Sivigik/SI_2015/dossier/emetteur.tex

\scalebox{0.5} % Change this value to rescale the drawing.
{
\begin{pspicture}(0,-7.03)(24.62,7.03)
\rput(12.31,0.0){}
\end{pspicture} 
}
