Sivigik/SI_2015/Partie vidéo robot SI.odt

Émetteur UHF vidéo

Le robot a pour principal objectif de découvrir des zones inaccessibles ou dangereuses à l'homme, ou un lieu trop exigu pour s'y déplacer.

La mise en place d'une retransmission vidéo est donc primordiale pour son contrôle par l'utilisateur.

Nous avons donc mis une caméra générant un signal vidéo composite, ce signal est envoyé par un émetteur UHF à distance pour être reçu par un écran positionné sur la manette de contrôle.

Signal vidéo composite

La caméra que nous utilisons ne gère pas la couleur, donc nous ne nous intéresserons pas à la porteuse couleur du signal.

Il existe plusieurs systèmes d'encodage, celui qui est ici employé est le PAL, ses caractéristiques sont qu'il transmet 25 images à la seconde pour une résolution max de 720 × 576 pixels.

Le signal véhicule les informations sous forme analogique et numérique,

la luminance (noir et blanc) par analogique, ce qui donne pour chaque ligne une période du signal, la tension du signal affichée dans le cadre rouge définit la luminance d'une ligne entière de l'écran, sa tension est définie entre 0,3V et 1V ; à 0,3V on a du noir, puis à 1V du blanc. Le signal présent dans les cadres bleus définit le début et la fin de ligne.

Synchronisation de ligne

Luminance pour une ligne

Luminance pour une ligne

Synchronisation de ligne

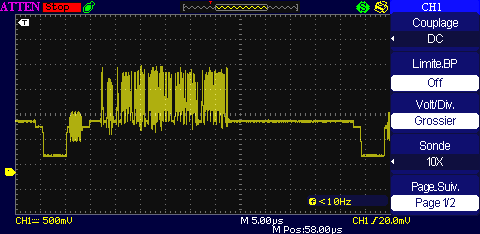
[picture p1: figure]

Vu d'un ensemble de ligne :

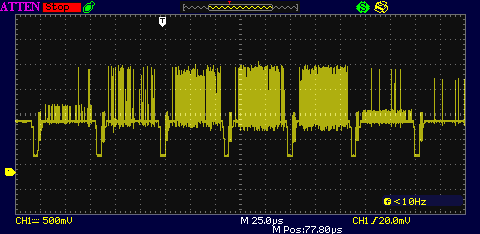
[picture p2: figure]

Il y a ensuite la synchronisation de frame qui est véhiculée par un signal numérique (il y passe aussi par cet endroit des informations sur la sources du signal, ici aucun car c'est une simple caméra).

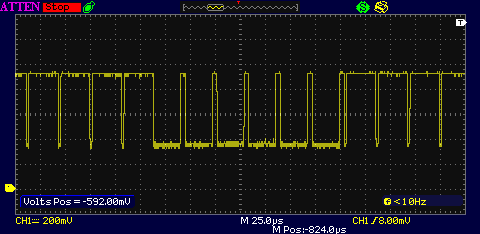
[picture p3: figure]

Se qui donne une image sous cette forme :

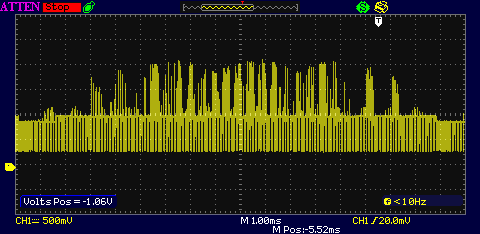
[picture p4: figure]

Émetteur UHF

Schéma :

L'émetteur est basé sur un oscillateur Colpitts, ce qui nous permet d'obtenir une fréquence élevée et stable avec seulement un transistor et quelques composants.

La fréquence de ce type d’oscillateur est donné par f= 1 over {2 %pi sqrt{L_1 times {{C_7 times C_2} over { C_7 + C_2}}}}

J'ai donc régler la fréquence de l'émetteur pour être entre la chaîne 58 et 60, soit entre 759,25 MHz

et 783,25 MHz, qui donne C_7 = 2pf C_2 = 10pF et L_1 = 20nH

donc f = 1 over { 2 %pi sqrt{{ 2.10^-8 {2 . 10^-12 times 1 . 10^-11} over {2 . 10^-12 + 1 . 10^-11}}}} = 8.71728.10^8 Hz soit 871,728MHz .

La transmission de données se fait par modulation de la fréquence, donc pour faire passer les informations vidéo il suffit de faire varier la tension aux bornes du condensateur C_2 , ce qui se répercute sur la fréquence d’oscillation. L'amplitude de modulation de la fréquence doit pouvoir être réglable pour avoir une transmission optimale.

Donc le signal vidéo composite passe par un potentiomètre, nous permettant ainsi de modifier son amplitude, puis le pont de résistance ne fait que protéger la caméra en cas de retour de tension de l'oscillateur.

L’antenne est directement mise sur la sortie de l'oscillateur, sa longueur dépend de la longueur d'onde, qui se calcule par la relation %lambda = c over f .

c vaut la vitesse de l'électricité soit 299 792 458 m.s^-1 et f = 871,728 . 10^6

%lambda = {299 792 458} over {871,728 . 10^6} = 0,3439 m

Aux vues de la puissance de transmission et du peu de place libre , j'ai opté de prendre un multiple de la longueur d'onde, soit, en divisant par 6, donc une longueur de 0,0573 m soit 57,3 mm .

Récepteur vidéo

La réception se fait par un TUNER d'un ancien téléviseur portable, sur lequel la sélection de la fréquence des chaînes se fait par la variation de tension sur une entrée du TUNER, puis il y a une sortie composite directement reliée à une entrée du circuit intégré CSC5151 qui contrôle le tube cathodique. Le signal composite est récupéré pour être affiché sur un écran LCD fixé sur la manette.
