Sivigik/SI_2015/diapo/IMG_1891.jpg

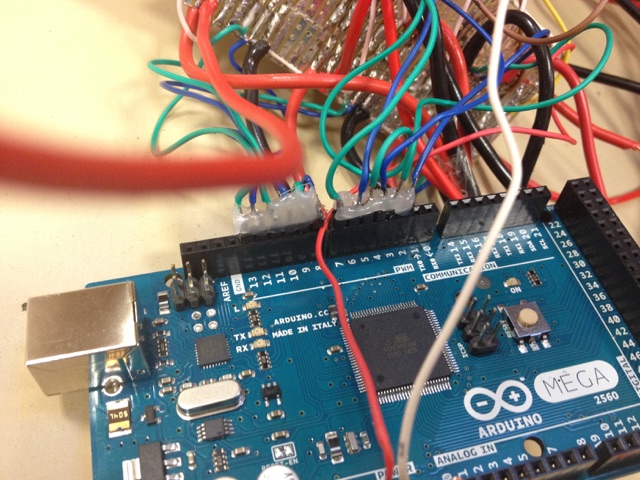
diapo/IMG_1891.jpg
