Sivigik/SI_2015/diapo/IMG_4512.jpg

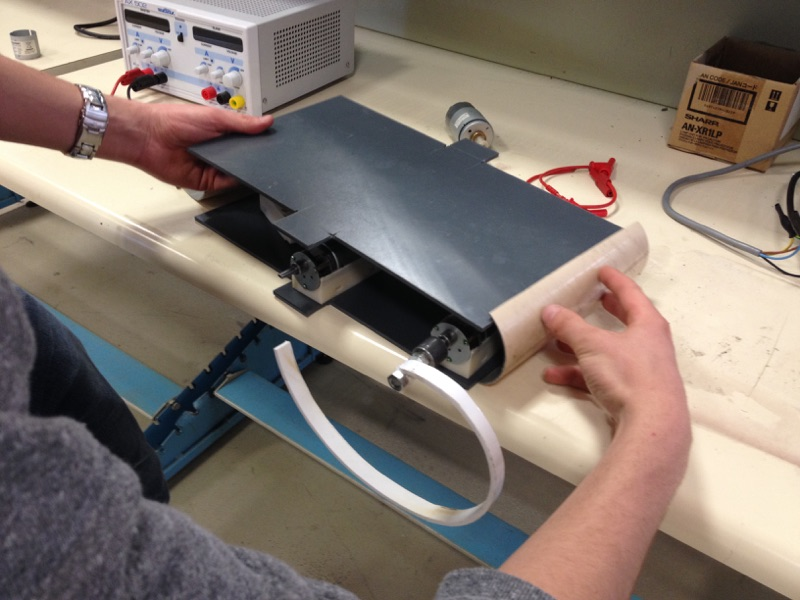
diapo/IMG_4512.jpg
