Sivigik/SI_2015/diapo/IMG_4847.jpg

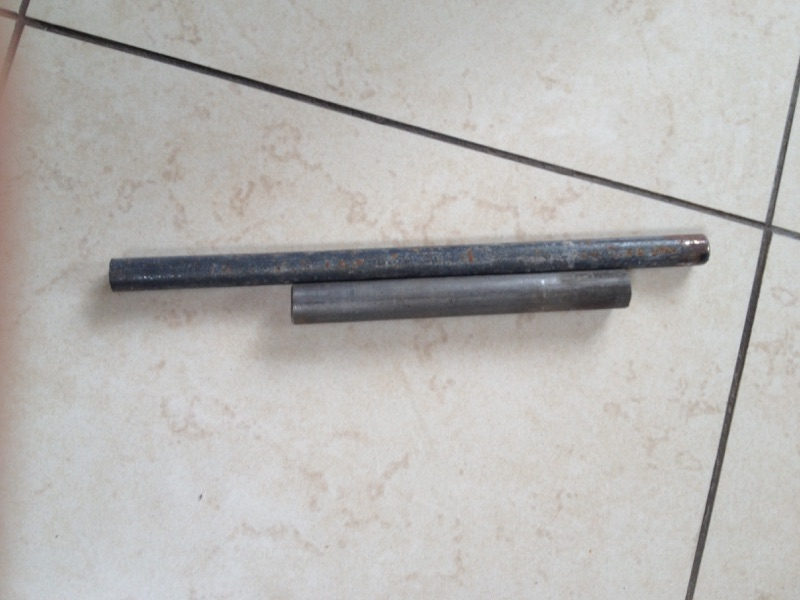
diapo/IMG_4847.jpg
