Sivigik/SI_2015/diapo/IMG_5082.jpg

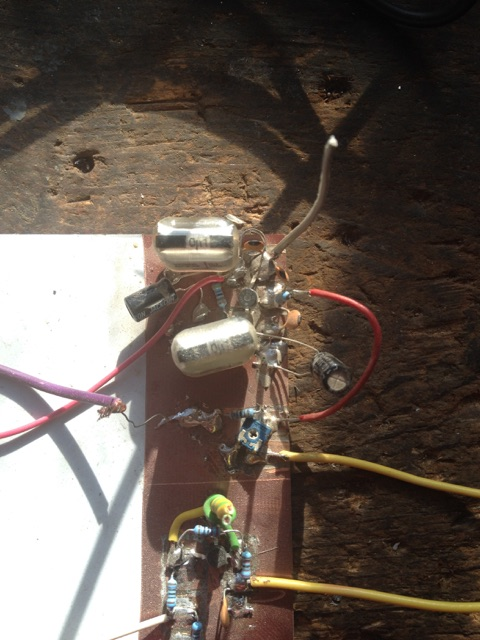
diapo/IMG_5082.jpg
