Sivigik/SI_2015/diapo/IMG_20150120_155957.jpg

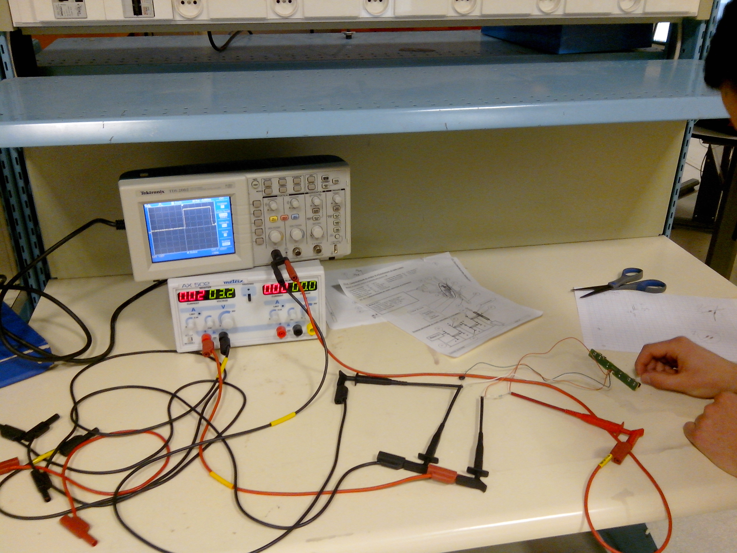
diapo/IMG_20150120_155957.jpg
