Sivigik/SI_2015/diapo/IMG_20150120_160013.jpg

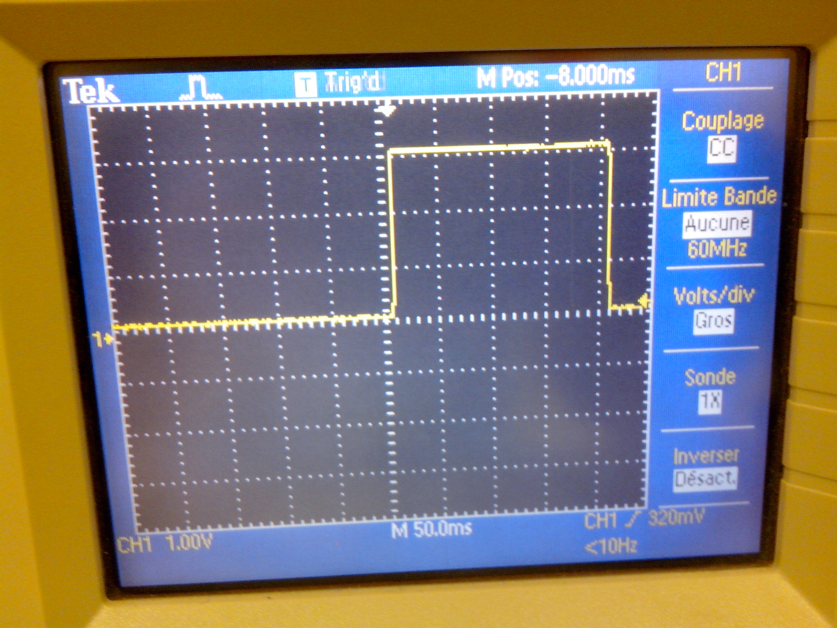
diapo/IMG_20150120_160013.jpg
