Sivigik/SI_2015/diapo/IMG_20150404_164022.jpg

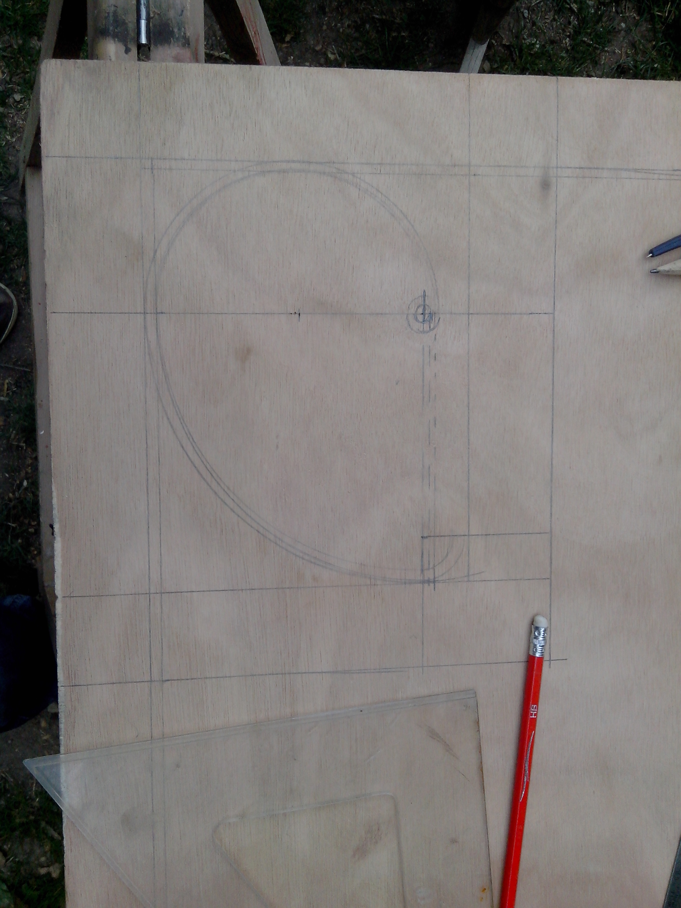
diapo/IMG_20150404_164022.jpg
