Sivigik/SI_2015/diapo/IMG_20150404_175506.jpg

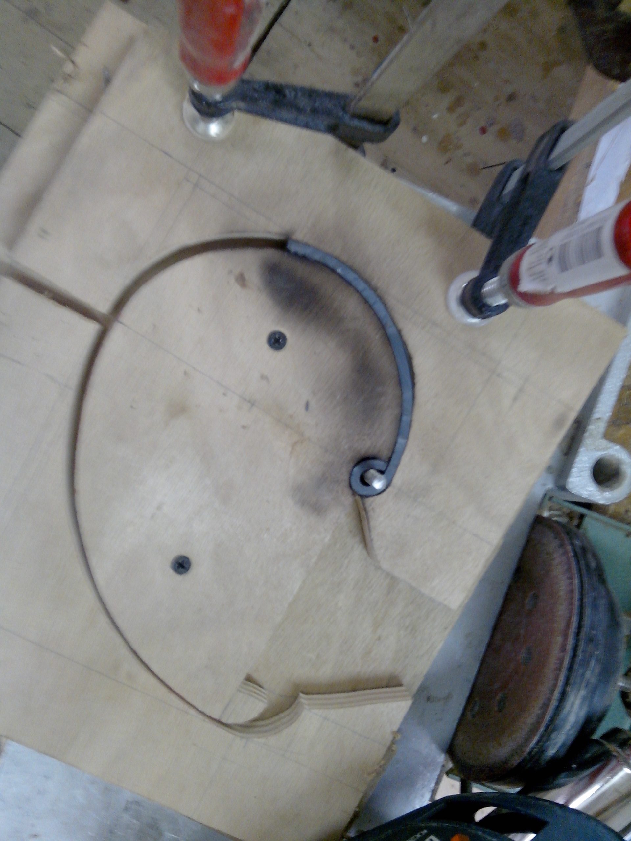
diapo/IMG_20150404_175506.jpg
