Sivigik/SI_2015/diapo/IMG_20150414_223907.jpg

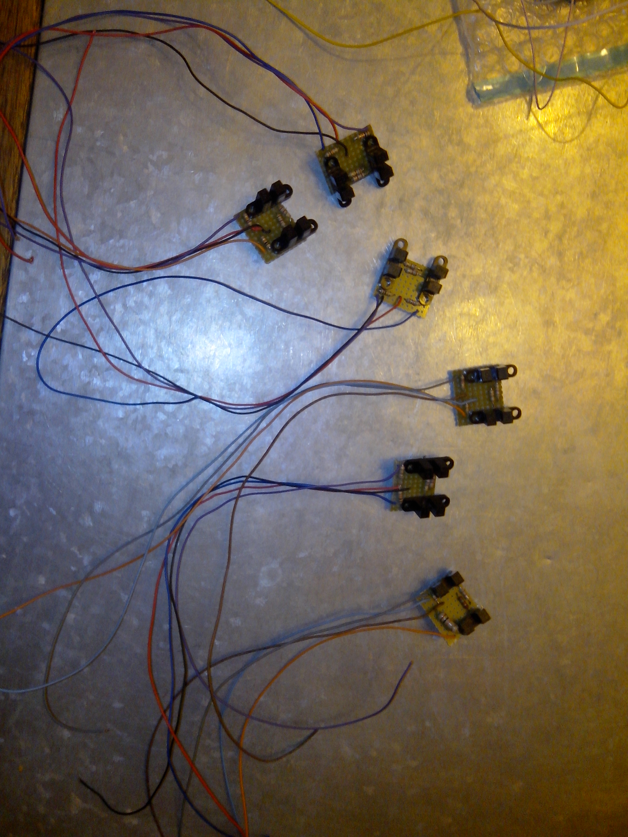
diapo/IMG_20150414_223907.jpg
