Sivigik/SI_2015/dossier/images/emetteur.png

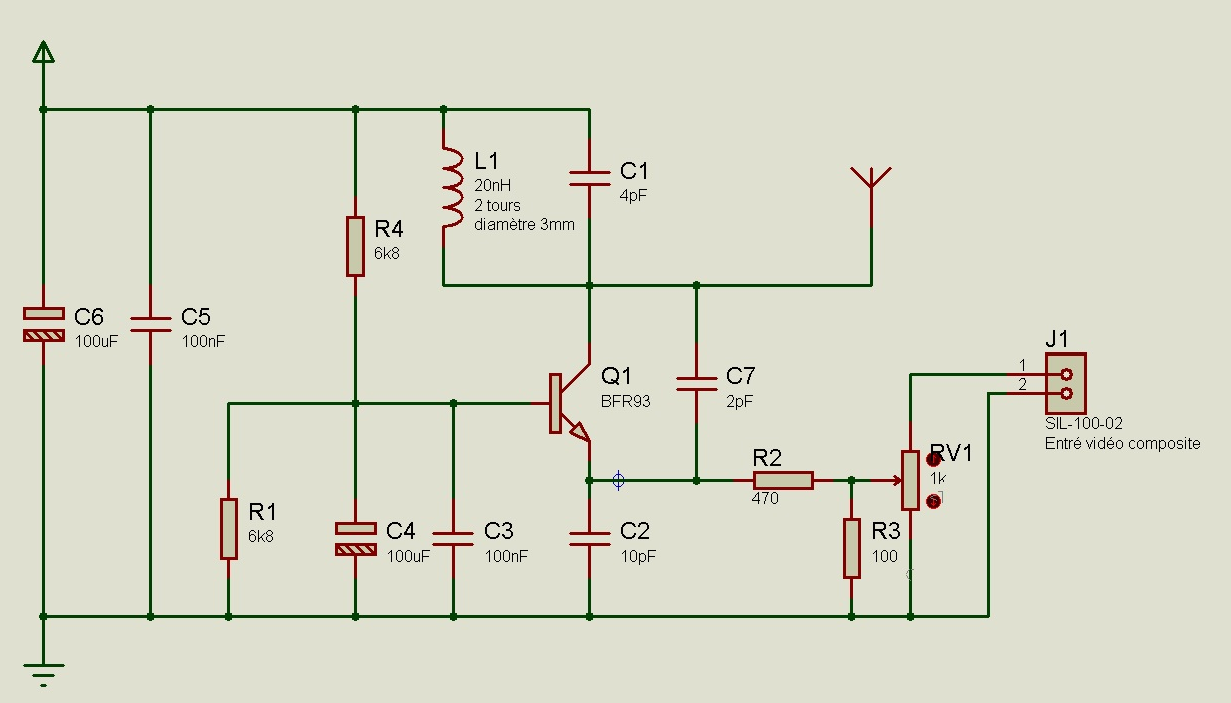
dossier/images/emetteur.png
