Sivigik/SI_2015/dossier/images/zoom sincro.BMP

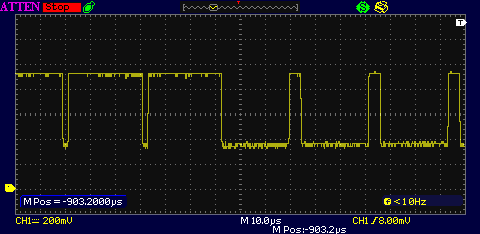
dossier/images/zoom sincro.BMP
