Sivigik/SI_2015/dossier/warning.png

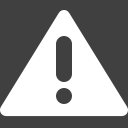
dossier/warning.png
