Sivigik/SI_2015/commande.ods

Produit | Qtée | ref | Info. Sup.
Moteur | 6 | RB350050-22723R | Datasheet ici, lien conrad (http://www.produktinfo.conrad.com/datenblaetter/225000-249999/233132-da-01-en-HOCHLEISTUNGSGETRIEBEMOTOR_12V_DC_1_50.pdf)
Arduino Uno OU Arduino Mini | 1 |  | Pour la télécommande
Arduino Mega 2560 | 1 |  | Pour le contrôle du robot
Photo-interupteur | 12 | ROHM 574 | Datasheet (http://pdf1.alldatasheet.fr/datasheet-pdf/view/36616/ROHM/RPI-574.html)
Module émission/réception wifi + antenne | 2 | NRF24L01 | Lien ebay (http://www.ebay.com/itm/Arduino-2-4G-NRF24L01-Wireless-Transceiver-Module-SMA-Antenna-Microcontroll-/200932672566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)
Câble électrique
