Sivigik/SI_2015/Modelisation3D/Assemblage.SLDASM

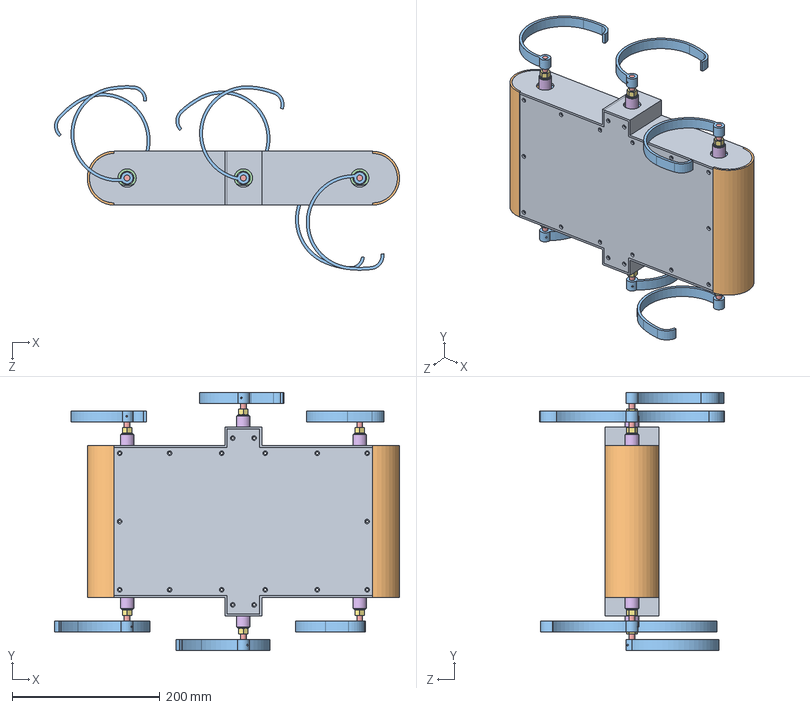
[picture p23: CAD file, 2015-03-20]
Modelisation3D/Assemblage.SLDASM
467.2 x 349.8 x 250.0 mm
Caisse_bas x 2
Cornière2 x 4
lit_moteur x 6
Moteur x 6
Rallonge_axe x 6
Rondelles_axes x 6
hex nut gradec_iso x 6
plain washer chamfered grade a_iso x 6
Coté 1 x 2
Parechoc x 2
patte x 6
