Sivigik/SI_2015/HUgoPI.STL

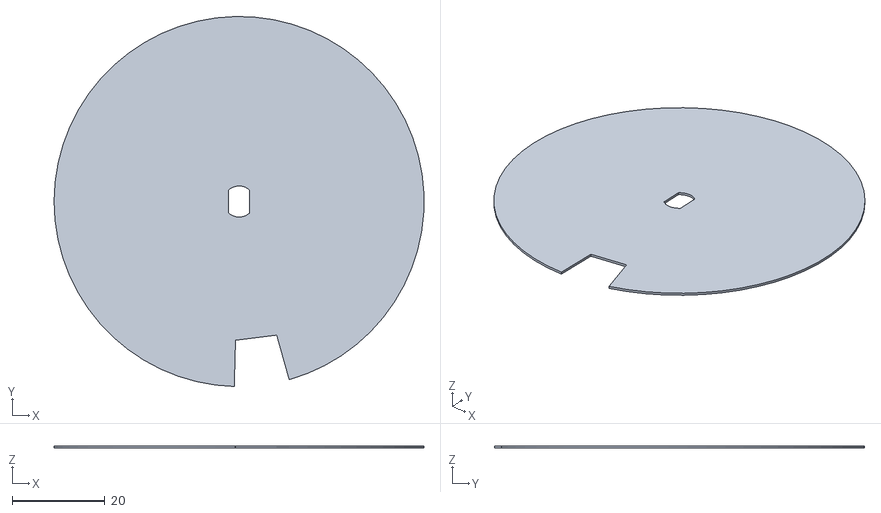
[picture p24: CAD file, 2015-03-20]
HUgoPI.STL
80.0 x 80.0 x 0.5
