Sivigik/SI_2015/Modelisation3D/lit_moteur central.sldprt

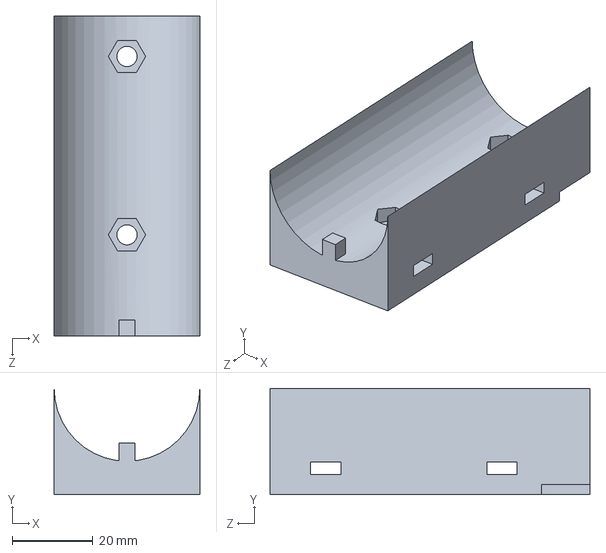
[picture p25: CAD file, 2015-05-08]
Modelisation3D/lit_moteur central.sldprt
36.0 x 26.2 x 79.1 mm
