Sivigik/SI_2015/Modelisation3D/lit_moteur.sldprt

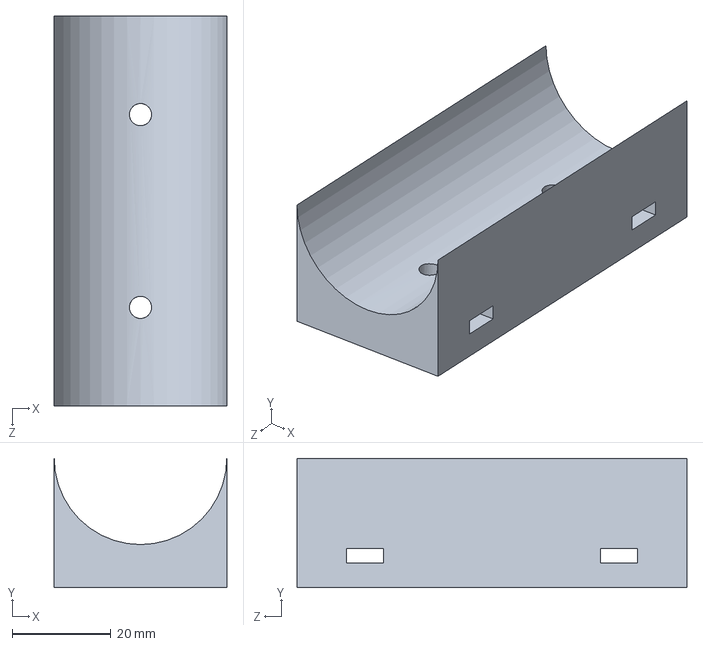
[picture p26: CAD file, 2015-03-20]
Modelisation3D/lit_moteur.sldprt
35.0 x 26.2 x 79.1 mm
