Sivigik/SI_2015/Modelisation3D/Rallonge_axe.SLDPRT

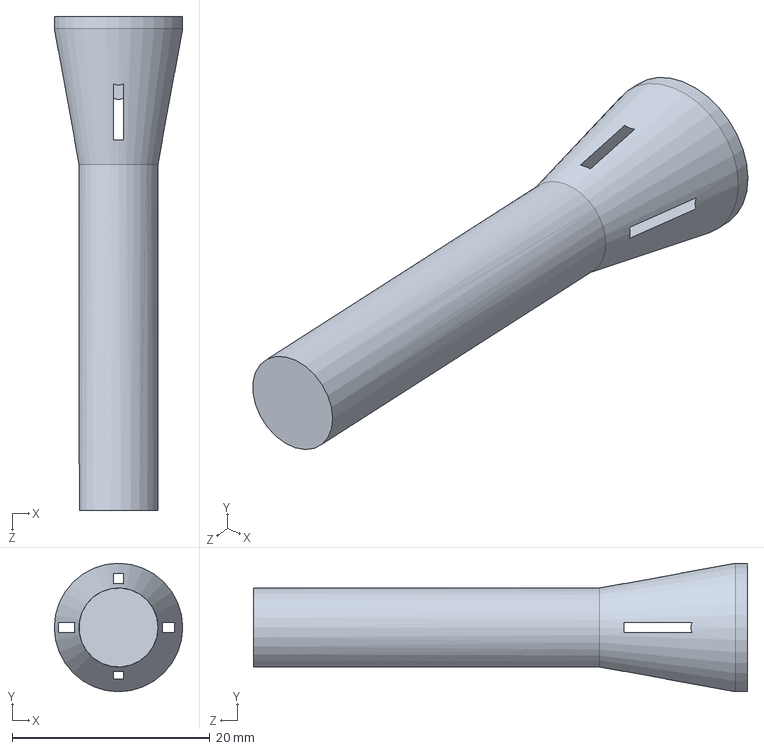
[picture p27: CAD file, 2015-03-20]
Modelisation3D/Rallonge_axe.SLDPRT
13.0 x 13.0 x 50.0 mm
