Sivigik/SI_2015/Modelisation3D/patte.SLDPRT

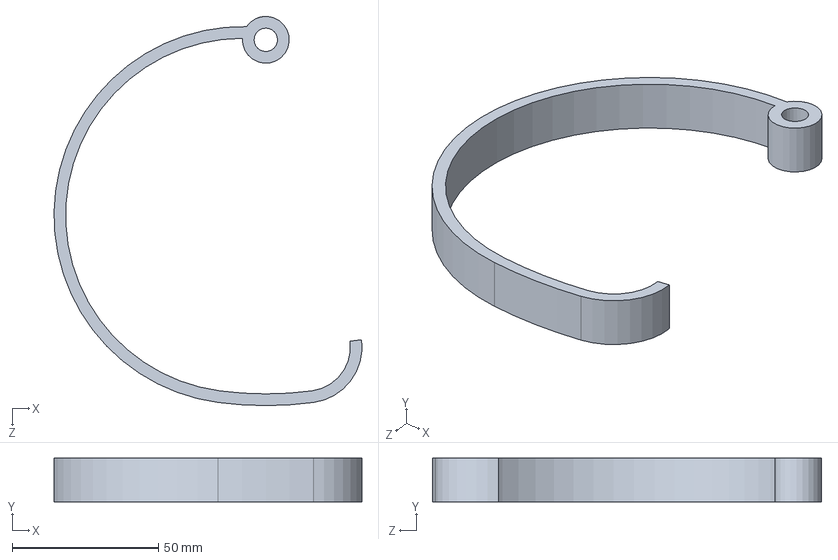
[picture p28: CAD file, 2015-03-20]
Modelisation3D/patte.SLDPRT
105.3 x 15.0 x 133.0 mm
