Sivigik/SI_2015/Modelisation3D/Rondelles_axes.SLDPRT

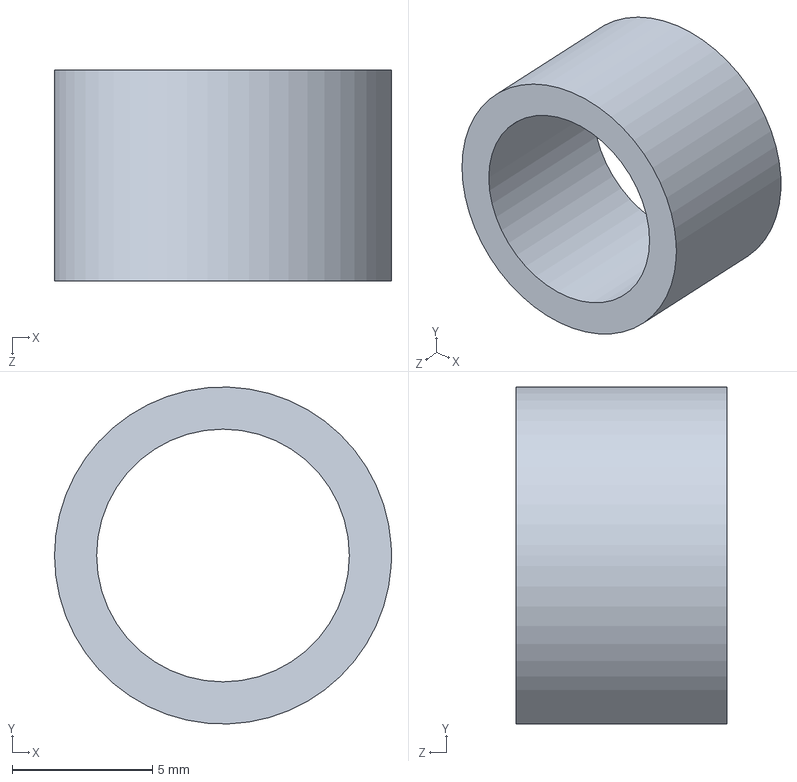
[picture p29: CAD file, 2015-03-20]
Modelisation3D/Rondelles_axes.SLDPRT
12.0 x 12.0 x 7.50 mm
