Sivigik/SI_2015/Modelisation3D/Cornière.sldprt

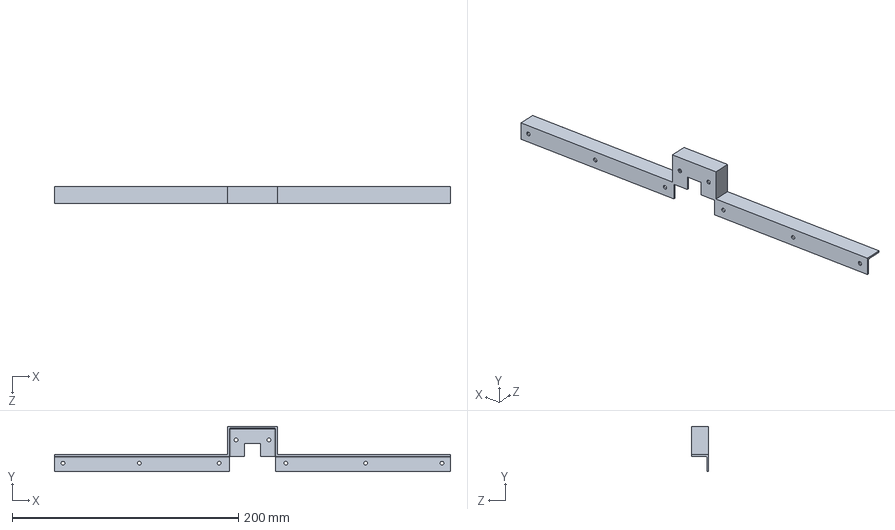
[picture p30: CAD file, 2015-03-20]
Modelisation3D/Cornière.sldprt
350.0 x 40.0 x 15.0 mm
