Sivigik/SI_2015/Modelisation3D/Caisse_bas.SLDPRT

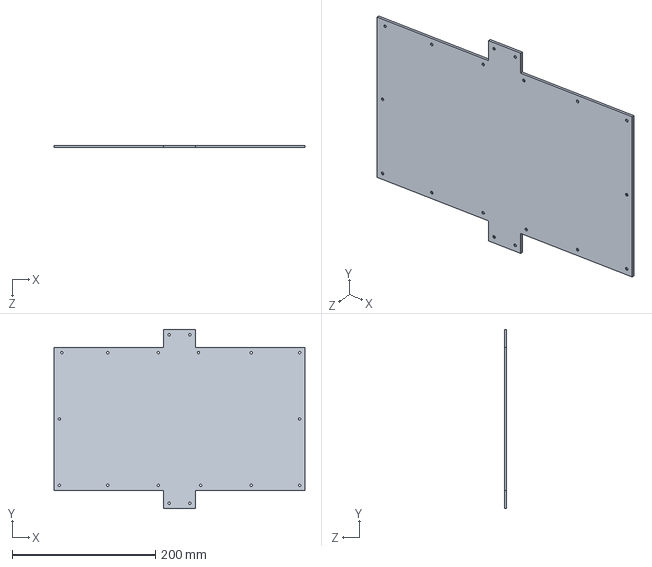
[picture p31: CAD file, 2015-03-20]
Modelisation3D/Caisse_bas.SLDPRT
350.0 x 250.0 x 3.00 mm
