Sivigik/SI_2015/Modelisation3D/Moteur.sldprt

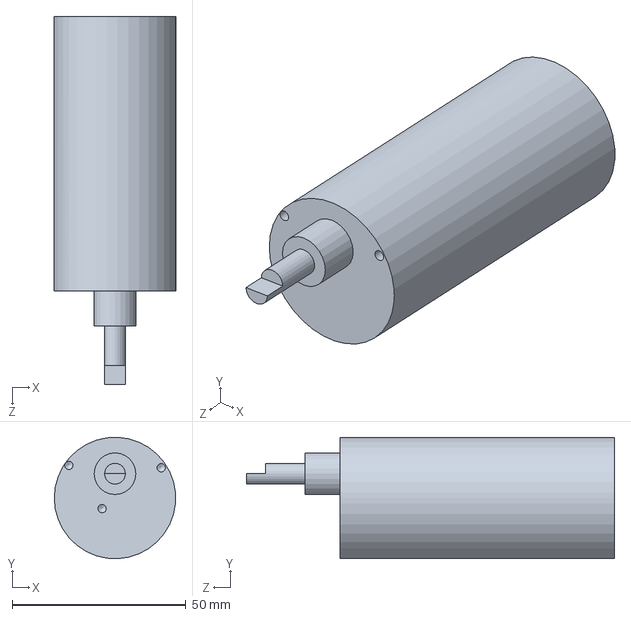
[picture p32: CAD file, 2015-03-20]
Modelisation3D/Moteur.sldprt
35.0 x 35.0 x 106.0 mm
