Sivigik/SI_2015/(list of files, cad)

Other CAD files:
Pièce1.SLDPRT
Modelisation3D/Cornière2.sldprt
Modelisation3D/Rallonge_axe.SLDDRW
Modelisation3D/lit_moteur central.STL
Modelisation3D/lit_moteur.STL
