Sivigik/SI_2015/dossier/titre.pdf

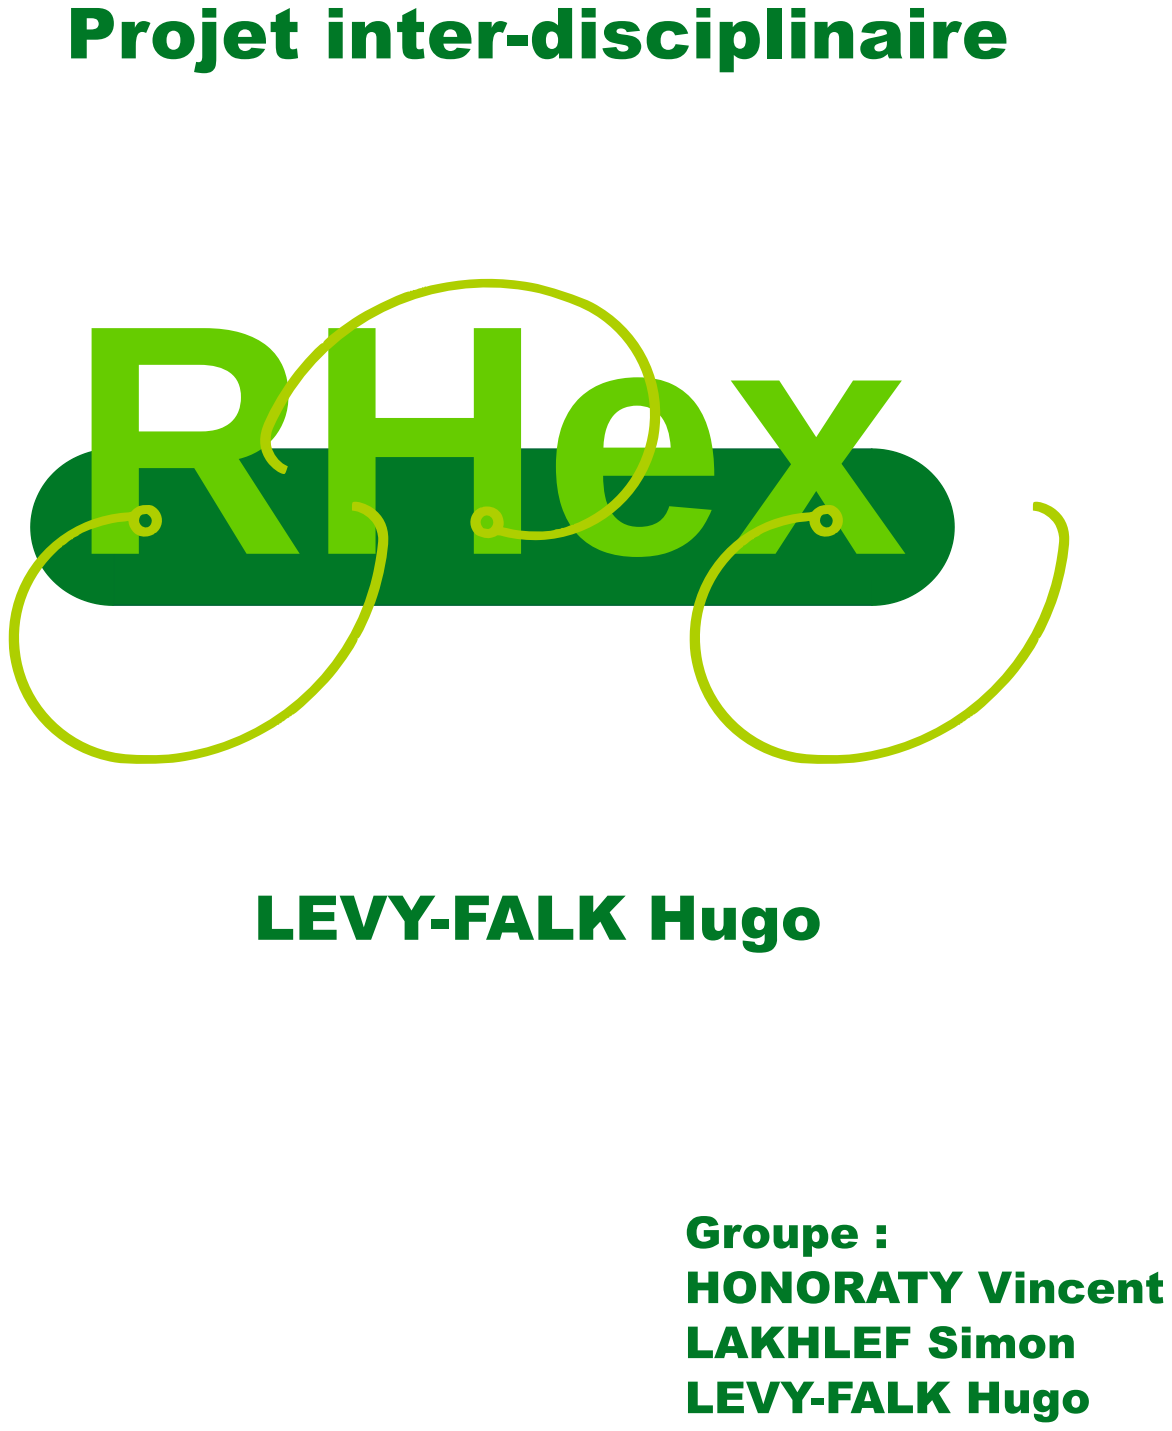
[picture p33: page 1]
