Sivigik/SI_2015/Arduino/Telecommande/Telecommande.ino

#include "VirtualWire.h"

//#define DEBUG

#ifdef DEBUG
#define dinfo(msg) Serial.println(msg)
#define dvar(var) Serial.print(#var);Serial.print(":");Serial.println(var)
#else
#define dinfo(msg)
#define dvar(var)
#endif

#define DIR 0
#define VITESSE 1

#define GAUCHE 0
#define DROITE 1
#define AVANT 2
#define ARRIERE 3 

uint8_t toSend[] = {0, 0};

const uint8_t bp_avance = 6;
const uint8_t bp_recule = 5;
const uint8_t bp_gauche = 4;
const uint8_t bp_droite = 3;
const uint8_t potar = 0;

void readValues();

void setup()
{
#ifdef DEBUG
    Serial.begin(9600);
#endif
    dinfo("Déboguage.");

    pinMode(bp_avance, OUTPUT);
    pinMode(bp_recule, OUTPUT);
    pinMode(bp_gauche, OUTPUT);
    pinMode(bp_droite, OUTPUT);
    
    digitalWrite(bp_avance, HIGH);
    digitalWrite(bp_recule, HIGH);
    digitalWrite(bp_gauche, HIGH);
    digitalWrite(bp_droite, HIGH);
 
    vw_setup(2000);
}
 
void loop()
{
    dinfo("LECTURE DES VALEURS");

    readValues();

    dvar(toSend[VITESSE]);
    dvar(toSend[DIR]);

    dinfo("TRANSMISSION");
    dvar(toSend[VITESSE]);
    dvar(toSend[DIR]);


    vw_send(toSend, 2);
    vw_wait_tx();

    dinfo("FIN");

#ifdef DEBUG
    delay(1500);
#else
    delay(100);
#endif
}

void readValues()
{
    dvar(analogRead(potar));
    toSend[VITESSE] = map(analogRead(potar), 0, 1024, 0, 255);
    
    dvar(digitalRead(bp_recule));
    dvar(digitalRead(bp_avance));
    dvar(digitalRead(bp_gauche));
    dvar(digitalRead(bp_droite));

    if (!digitalRead(bp_recule))
    {
        if(!(toSend[DIR]&(1<<AVANT)))
            toSend[DIR] |= (1<<ARRIERE);
        
        toSend[DIR] &= ~(1<<AVANT);
        dvar(toSend[DIR]);
    }

    if (!digitalRead(bp_avance))
    {
        if(!(toSend[DIR]&(1<<ARRIERE)))
            toSend[DIR] |= (1<<AVANT);
        
        toSend[DIR] &= ~(1<<ARRIERE);
    }

    if (!digitalRead(bp_gauche))
    {
        toSend[DIR] |= (1<<GAUCHE);
        toSend[DIR] &= ~(1<<DROITE);
    }

    else if (!digitalRead(bp_droite))
    {
        toSend[DIR] |= (1<<DROITE);
        toSend[DIR] &= ~(1<<GAUCHE);
    }
    
    else
    {
      toSend[DIR] &= ~(1<<GAUCHE);
      toSend[DIR] &= ~(1<<DROITE);
    }

}
