Sivigik/SI_2015/Arduino/Robot/settings.h

#ifndef H_SETTINGS
#define H_SETTINGS
#define PI 1

const int PORTION_SOL = 11/12*PI; // en °
const int PORTION_AIR = 2*PI - PORTION_SOL;

const int RAYON_PATTE = 0.15; // en m

const char SOL = HIGH;
const char AIR = LOW;

const int VITESSE_MAX_MOTEUR = 109; // tr.min-1

const char INIT_MODE_1 = SOL;
const char INIT_MODE_2 = AIR;


#endif
