Sivigik/SI_2015/(commit log)

2015-03-20 Ajout des fichiers.
    [Assemblage.SLDASM, Caisse_bas.SLDPRT, Cornière.sldprt, Cornière2.sldprt, HUgoPI.STL, Moteur.sldprt, Pièce1.SLDPRT, commande.ods]
2015-03-20 Mise à jour des modèles 3D.
    [Assemblage.SLDASM, Rallonge_axe.SLDDRW, Rallonge_axe.SLDPRT, Rondelles_axes.SLDPRT, lit_moteur.sldprt, patte.SLDPRT]
2015-03-20 Mise à jour des modèles 3D
    [Assemblage.SLDASM, Rallonge_axe.SLDDRW, Rallonge_axe.SLDPRT, Rondelles_axes.SLDPRT, lit_moteur.sldprt, patte.SLDPRT]
2015-04-07 Contrôle des pattes.
2015-04-07 Ajout des lits moteurs.
    [lit_moteur central.STL, lit_moteur central.sldprt, lit_moteur.STL, lit_moteur.sldprt]
2015-04-09 Ajout du code pour la télécommande
2015-04-12 Ajout de la documentation sur la vidéo Signed-off-by: vinvin-win <v.honnoraty@gmail.com>
2015-04-12 Début de rédaction.
2015-04-15 Ajout de VirtualWire, réception sur le robot et contrôle des moteurs.
